hanskimvz/NS6202HD/11.png

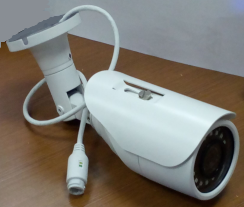
11.png
