hanskimvz/NS6202HD/schematic/NS6202_V4.1.PcbDoc.htm

Reporting Options

# File in Previous Format

Date | : | 2024-02-29
Time | : | 오후 3:50:26
Filename | : | D:\BACKUP\Hardwares\NS6202HD\schematic\NS6202_V4.1.PcbDoc

Version | Warning

This file was generated by an earlier version of the software
