hanskimvz/NS6202HD/schematic/NS6202_V4.0_b.PcbDoc.htm

Reporting Options

# File in Newer Format

Date | : | 2023-11-30
Time | : | 오후 5:58:30
Filename | : | D:\H_BAIDU\PROJECT\NS6202_IPN\schematic\NS6202_V4.0_b.PcbDoc

Version | Warning
Release 15 | CAUTION - Support of separate solder masks for top & bottom of pads added.
Release 15.1 | CAUTION - Support Multi-line PCB Text added.
Release 16.0 | CAUTION - Pad/Via hole size tolerance value added.
Release 17.0 | CAUTION - Component parameters added.
Release 17.0 | CAUTION - Support of backdrilling
Release 17.1 | CAUTION - Support of waived violations
Release 17.1 | CAUTION - Support of object specific keepouts

This file was generated by a later version of the software
