hanskimvz/NS6202HD/SMART IR Board PIC.jpg

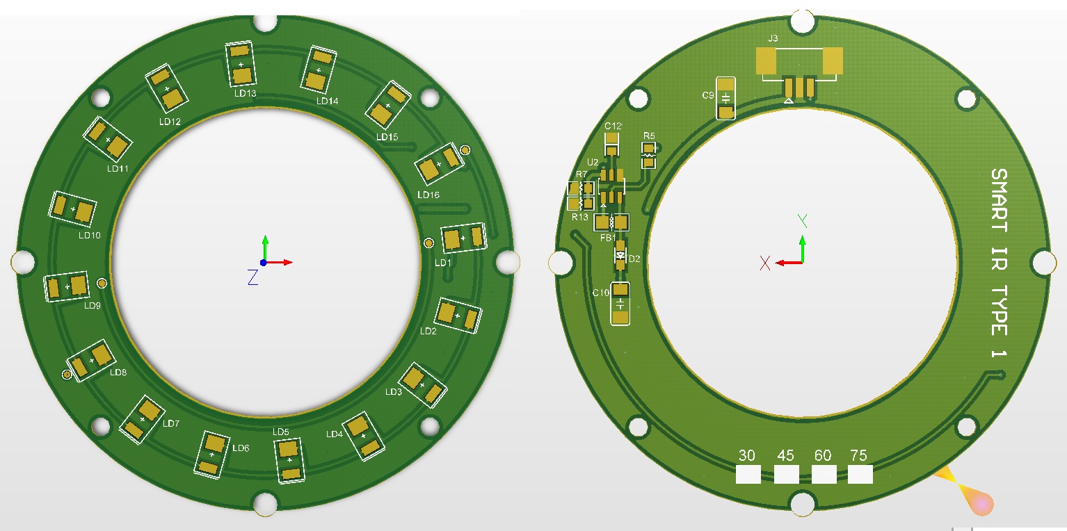
SMART IR Board PIC.jpg
