hanskimvz/NS6202HD/NS6202HD_Product_MC.xlsx

 |  |  | USD | CNY | Quantity | USD | CNY
1 | NVN042M |  | 34 |  | 1 | 34 | 0 |  | SEJIN
2 | Manu. Royalty |  | 5 |  | 1 | 5 | 0 |  | UDP
3 | IMA1102 |  | 22 |  | 1 | 22 | 0 |  | SEJIN
 | NS6202HD_Board |  | 10 |  | 1 | 10 | 0
5 | IR Board |  |  | 18 | 1 | 0 | 18
6 | Chassis |  |  | 37 | 1 | 0 | 37 |  | order made
 | Thermal Bracket |  |  | 14 | 1 | 0 | 14 |  | order made
8 | LAN/Power Cable |  |  | 9 | 1 | 0 | 9 |  | order made
9 | Lens | 6mm |  | 11 | 1 | 0 | 11 |  | https://item.taobao.com/item.htm?spm=a1z10.5-c.w4002-7821947878.21.Xr6X1F&id=41694765811
10 | IR-cut | M12 Ir-cut |  | 3.5 | 1 | 0 | 3.5 |  | https://item.taobao.com/item.htm?spm=a1z0d.7625083.1998302264.5.voLotO&id=41616812732
11 | Bolt | m2_3mm, IRCUT |  | 0.1 | 2 | 0 | 0.2
12 | Bolt | m1.5_3mm/Lens |  | 0.1 | 1 | 0 | 0.1
13 | PSU | 12V DC 1A |  | 15 | 0 | 0 | 0 |  | https://item.taobao.com/item.htm?spm=a230r.1.14.16.X3Y5ct&id=16992516911&ns=1&abbucket=13#detail
14 | support | m2_0+2+0 |  | 0.1 | 4 | 0 | 0.4
 |  | m2_0+18+3 |  | 0.24 | 4 | 0 | 0.96 |  | https://item.taobao.com/item.htm?spm=a1z0d.6639537.1997196601.112.pfU5WP&id=26042080370
 |  | m2_0+13+3 |  | 0.24 | 4 | 0 | 0.96
 |  | m2_0+4+0 |  | 0.16 | 4 | 0 | 0.64
18 | bolt | m2_5mm |  | 0.1 | 4 | 0 | 0.4
19 | Cable | IR-b'rd to ext |  | 0.2 | 1 | 0 | 0.2
 |  |  |  | 0.1 |  | 0 | 0
21 | Packing |  |  | 5 | 1 | 0 | 5
 | Lic(surv) |  | 37 |  | 0.2 | 7.4 | 0
 | Delivery(K-C) |  |  | 4 | 0 | 0 | 0
 |  |  |  |  |  | 78.4 | 101.36
 |  |  |  | Exchange Rate | 7 | 548.8 | 101.36 | 650.16 |  | 1600 | 949.84
 |  |  |  |  |  |  |  | 715.176
