hanskimvz/NS6202HD/NS6202HD_Product_PL.xlsx

Sheet: PL
No. | Part/Item | Descrition | Q'ty | Source
1 | NVN042M | VCA and Compression module | 1 | SEJIN | SEJIN
2 | IMA1102 | Image Sensor board | 1 | SEJIN | SEJIN
3 | SC6202HD_Ext | Extention board | 1 | SEJIN
4 | NS6202IR | IR Board | 1 | SEJIN
5 | Chassis B75A | Case for Bullet Camera | 1 | ECCLE
6 | Thermal Bracket |  | 1 | ECCLE
7 | LAN/Power Cable |  | 1 | XIngFeng
8 | Lens | 4mm focal lenght | 1 | ChuangYueVision
9 | IR-cut | M12 Ir-cut | 1 | ChuangYueVision
10 | Bolt | m2_3mm, IRCUT | 1
11 | Bolt | m1.5_3mm/Lens | 1
12 | PSU | 12V DC 1A | 1
13 | support | m2_0+2+0 | 1
14 | support | m2_0+18+3 | 1
15 | support | m2_0+13+3 | 1
16 | support | m2_0+4+0 | 1
17 | bolt | m2_5mm | 1
18 | Cable | IR-b'rd to ext | 1

Sheet: SC6202IR
 |  |  | 30degree IR Board |  | 60degree IR Board
Item | Quantity | Reference | Part | Footprint | Part | Footprint
1 | 2 | C9,C10 | 4.7uF-25V-3216 | C3216 | 4.7uF-25V-3216 | C3216
2 | 1 | C12 | 220nF | CS-1608 | 220nF | CS-1608
3 | 1 | D2 | DFLS140 | DS-KDS160 | DFLS140 | DS-KDS160
4 | 1 | FB1 | 60 | LS-2012 | 60 | LS-2012
5 | 1 | J3 | 12505WS-03 | 12505WS-3P | 12505WS-03 | 12505WS-3P
6 | 16 | LD1,LD2,LD3,LD4,LD5,LD6,LD7,LD8,LD9,LD10,LD11,LD12,LD13,LD14,LD15,LD16 | LTJI0108W30 | SMD_IR_LED | LTJI0106W30 | SMD_IR_LED
7 | 1 | R5 | 33 | RS-1608 | 33 | RS-1608
8 | 2 | R7,R13 | 2_F | RS-1608 | 4.99F | RS-1608
10 | 1 | U2 | TPS61165DBVR | SOT23-6 | TPS61165DBVR | SOT23-6

Sheet: SC6202HD_EXT
 | Comment | Designator | Footprint | LibRef | Quantity | MQT
1 | 0.1uF | BC1, BC3, BC4, BC5, BC6, BC7, BC9, C12, C13, C23, C28 | CS-1005 | 0.1uF | 11 | 11
2 | 0.1uF | BC2, C1, C24, C25 | CS-1608 | 0.1uF | 4 | 4
3 | 10uF | BC10, C8 | CTS-3216 | 10uF | 2 | 0
4 | 220pF | C2 | CS-1005 | 220pF | 1 | 1
5 | 1nF | C3 | CS-1005 | 1nF | 1 | 1
6 | 2.2nF | C4, C5 | CS-1005 | 2.2nF | 2 | 2
7 | 10nF | C6, C7, C15, C20, C21 | CS-1005 | 10nF | 5 | 5
8 | 47pF | C9 | CS-1005 | 47pF | 1 | 1
9 | 22uF | C10 | CTS-3216 | 22uF | 1 | 0
10 | 4.7uF-25V | C11 | C3216 | 4.7uF-25V | 1 | 1
11 | 3.3nF | C14 | CS-1005 | 3.3nF | 1 | 1
12 | 22uF-2012-6.3V | C16, C17 | CS-2012 | 22uF-2012-6.3V | 2 | 2
13 | 2.2uF | C22, C27 | CS-1608 | 2.2uF | 2 | 0
14 | 22uF | C26 | CS-2012 | 22uF | 1 | 0
15 | RB051L-40 | D1 | SOD-106 | RB051L-40 | 1 | 1
16 | 1N4148 | D2 | SOD-523 | 1N4148 | 1 | 1
17 | 60 | FB2, FB3, FB4 | LS-1608 | 60 | 3 | 3
18 | AXK6F50547 | J1,J2 | AXK6F50547 | AXK6F50547 | 2 | 2
19 | 12505WS-08 | J3 | 12505WS-8P | 12505WS-08 | 1 | 1
20 | 12505WS-08 | J12 | 12505WS-8P | 12505WS-08 | 1 | 0
21 | 05005HS-40 | J4 | 05005HS-40P | 05005HS-40 | 1 | 1
22 | 12505WS-06 | J5 | 12505WS-6P | 12505WS-06 | 1 | 1
23 | 12505WS-06 | J9 | 12505WS-6P | 12505WS-06 | 1 | 1
24 | 05005HS-40 | J6 | 05005HS-10P | 05005HS-40 | 1 | 1
25 | 12505WS-04 | J11 | 12505WS-4P | 12505WS-04 | 1 | 0
26 | 12505WS-03 | J13 | 12505WS-3P | 12505WS-03 | 1 | 0
27 | CDRH5D18NP-100NC-10uH | L1 | CDRH5D18NP | CDRH5D18NP-100NC-10uH | 1 | 1
28 | 4.04pi | MH1, MH2, MH3, MH4 | VA-2.2 | 4.04pi | 4 | 0
29 | PC817 | PC1 | PC817 | PC817 | 1 | 1
30 | ASSR-4118 | PC2 | ASSR-4118 | ASSR-4118 | 1 | 1
31 | MMBT6427 | Q1, Q2, Q4 | SOT-23 | MMBT6427 | 3 | 3
32 | MMBT3906 | Q3 | SOT-23 | MMBT3906 | 1 | 1
33 | 10K | R3, R4, R7, R8, R9, R11, R16, R17, R22, R24, R25, R28, R56 | RS-1005 | 10K | 13 | 13
34 | 1K | R5, R6, R10, R15, R34, R36, R49, R50, R57 | RS-1005 | 1K | 9 | 9
35 | 330 | R12, R14 | RS-1005 | 330 | 2 | 2
36 | 2.2K | R13, R44, R47, R54 | RS-1005 | 2.2K | 4 | 4
37 | 47 | R23, R29 | RS-1005 | 47 | 2 | 2
38 | 120/NI | R26 | RS-1005 | 120/NI | 1 | 0
39 | 4.7K | R27, R35 | RS-1005 | 4.7K | 2 | 2
40 | 0 | R30, R39 | RS-1005 | 0 | 2 | 2
41 | 100 | R31, R38, R46, R48, R52 | RS-1005 | 100 | 5 | 5
42 | 75 | R32, R33 | RS-1005 | 75 | 2 | 2
43 | 9.1_F | R37, R40, R45, R51 | RS-1005 | 9.1_F | 4 | 4
44 | 100K | R41 | RS-1005 | 100K | 1 | 1
45 | 26.1K_1% | R42 | RS-1005 | 26.1K_1% | 1 | 1
46 | 10K_1% | R43 | RS-1005 | 10K_1% | 1 | 1
47 | 2.2K//NI | R53 | RS-1005 | 2.2K//NI | 1 | 0
48 | 10 | R55 | RS-1005 | 10 | 1 | 1
49 | 0/NI | R58 | RS-1005 | 0/NI | 1 | 0
50 | TRC41604NL | T1 | TRC41604NL | TRC41604NL | 1 | 1
51 | TP | TP1, TP2 | TP | TP | 2 | 0
52 | MAX3485ESA | U3 | SOIC-8 | MAX3485ESA | 1 | 1
53 | DRV8834PWP | U4, U6 | TSSOP-24-PAD | DRV8834PWP | 2 | 0
54 | MP1482 | U5 | SOIC-8 | MP1482 | 1 | 1
55 | LM386M-1 | U9 | SOIC-8 | LM386M-1 | 1 | 0
