hanskimvz/NS6202HD/NS6202HD V3.0 Board BOM.xlsx

TITLE Revised: Monday, November 06, 2017
NS6202HD Revision:3.0
Item | Quantity | Reference | Part | Footprint
1 | 4 | BC1,BC4,C35,C36 | 0.1uF | CS-1005
2 | 4 | C1,BC2,C24,C25 | 0.1uF | CS-1608
3 | 1 | BC38 | 22uF | CS-2012
4 | 1 | C2 | 1nF/NI | CS-1005
5 | 2 | C6,C7 | 2.2nF | CS-1005
6 | 1 | C31 | 10nF | CS-1005
7 | 3 | C32,C33,C38 | 22uF-2012-6.3V | CS-2012
8 | 1 | C34 | 4.7uF-25V | C3216
9 | 1 | C37 | 3.3nF | CS-1005
10 | 1 | D1 | 1N4001 | SOD-106
11 | 1 | D2 | 1N4148 | SOD-523
12 | 2 | FB5,FB7 | 60 | LS-1608
13 | 1 | FB6 | 60/NI | LS-1608 | NI
14 | 1 | J1 | AXK6F30547 | AXK6F50547
15 | 1 | J2 | AXK6F50347 | AXK6F50547
16 | 1 | J3 | 12505WS-08 | 12505WS-8P
17 | 1 | J4 | 05005HS-40 | 05005HS-40P
18 | 1 | J5 | 12505WS-06 | 12505WS-6P
19 | 1 | J6 | CON_u-SD/NI | CON_u-SD
20 | 1 | J7 | 12505WS-2P | 12505WS-2P
21 | 3 | J8,J9,J11 | 12505WS-4P | 12505WS-4P
22 | 1 | J12 | 12512WS-02 | 12512WS-2P
23 | 1 | L1 | CDRH5D18NP-100NC-10uH | CDRH5D18NP
24 | 4 | MH1,MH2,MH3,MH4 | 4.04pi | VA-2.2 | NI
25 | 1 | PC1 | PC817 | PC817
26 | 1 | PC2 | ASSR-4118
27 | 3 | Q1,Q2,Q4 | MMBT6427 | SOT-23
28 | 1 | Q3 | MMBT3906 | SOT-23
29 | 2 | RP6,RP7 | 10K | RP-4_1005
30 | 10 | R3,R4,R9,R11,R16,R17,R22, | 10K | RS-1005
 |  | R24,R25,R28
31 | 5 | R5,R6,R7,R10,R15 | 1K | RS-1005
32 | 1 | R8 | 0/NI | RS-1005
33 | 2 | R12,R14 | 330 | RS-1005
34 | 2 | R13,R44 | 2.2K | RS-1005
35 | 2 | R23,R29 | 47 | RS-1005
36 | 1 | R26 | 120/NI | RS-1005
37 | 1 | R31 | 100 | RS-1005
38 | 2 | R32,R33 | 75 | RS-1005
39 | 1 | R41 | 100K | RS-1005
40 | 1 | R42 | 26.1K_1% | RS-1005
41 | 1 | R43 | 10K_1% | RS-1005
42 | 1 | SW1 | SW PB | SWS-CTT-1131U
43 | 1 | T1 | TRC41604NL | TRC41604NL
44 | 1 | U3 | MAX3485ESA | SOIC-8
45 | 1 | U5 | MP1482 | SOIC-8
46 | 1 | U6 | 78L05 | SOT-89
