hanskimvz/NS6202HD/Chassis/NS6202_Cam_module.SLDASM

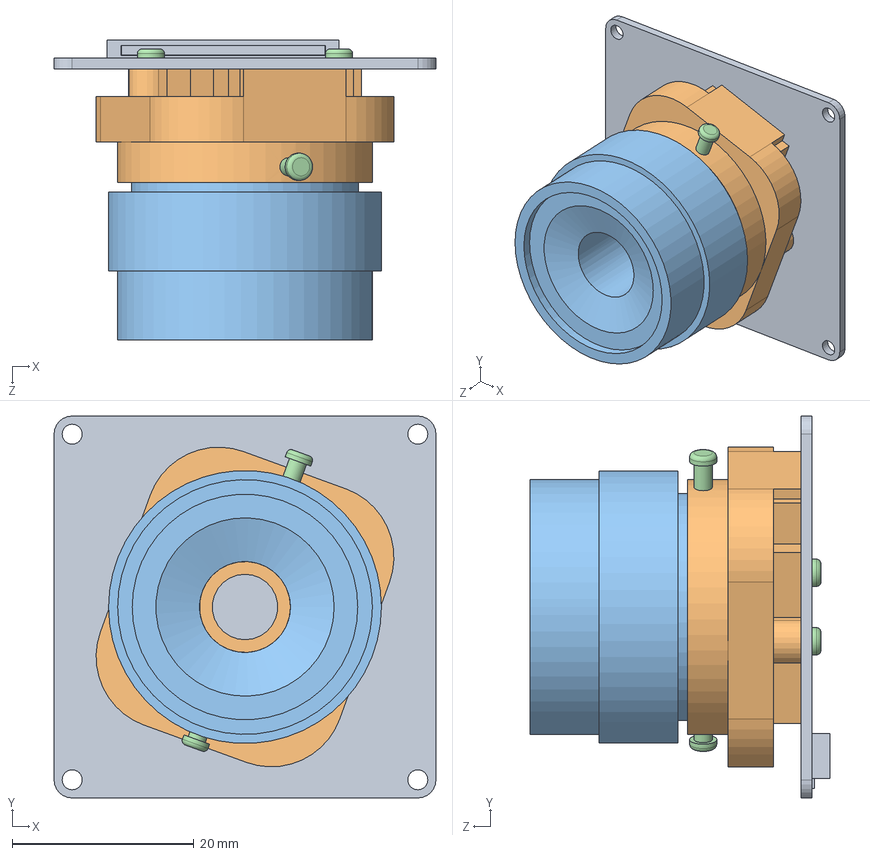
[picture p4: CAD file, 2024-02-29]
Chassis/NS6202_Cam_module.SLDASM
42.0 x 42.0 x 33.0 mm
IMA1102
IR_CUT_22mm_CS
3402Lens
bolt_m2_4mm x 4
