hanskimvz/NS6202HD/Chassis/NS6202.SLDASM

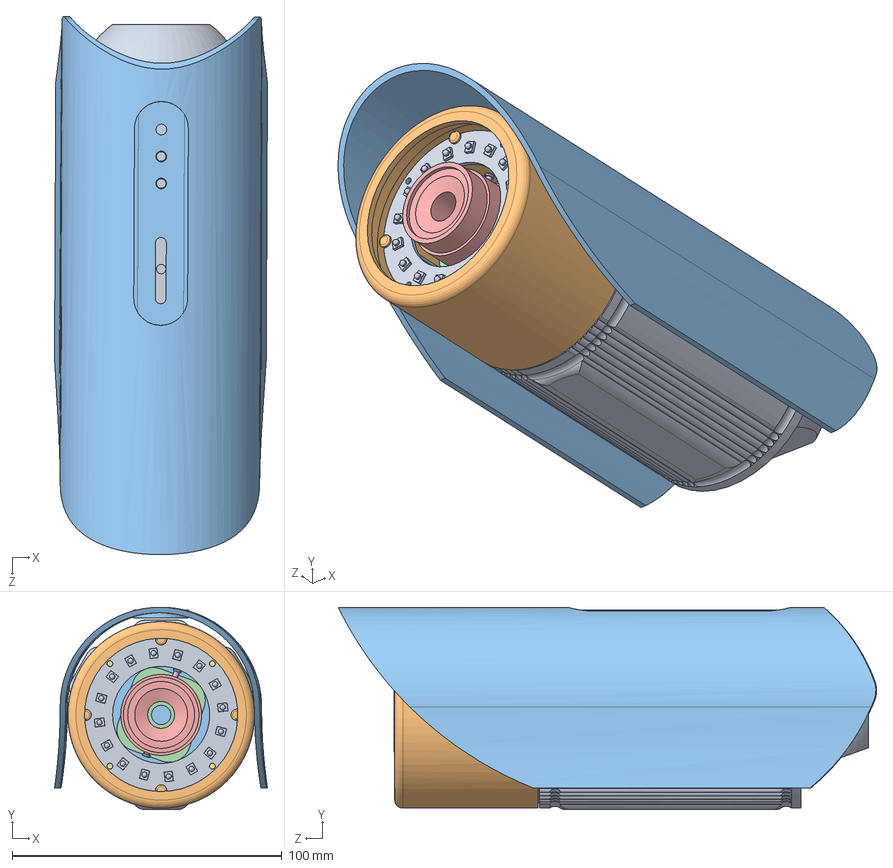
[picture p5: CAD file, 2024-02-29]
Chassis/NS6202.SLDASM
79.0 x 75.0 x 199.6 mm
NS6202_partition
Ext_board
NVN042M
support_m2_13mm x 4
bolt_m2_16mm x 4
support_m2_0_4_0mm x 4
support_m2_0_2_0mm x 4
IMA1102
IR_CUT_22mm_CS
3402Lens
bolt_m2_4mm x 4
bolt_m2_5mm x 4
support_m2.5_33mm,10-0 x 4
IR_Bord
bolt_m2.5_5mm x 4
