hanskimvz/NS6202HD/Chassis/NS6202_cam_body.SLDASM

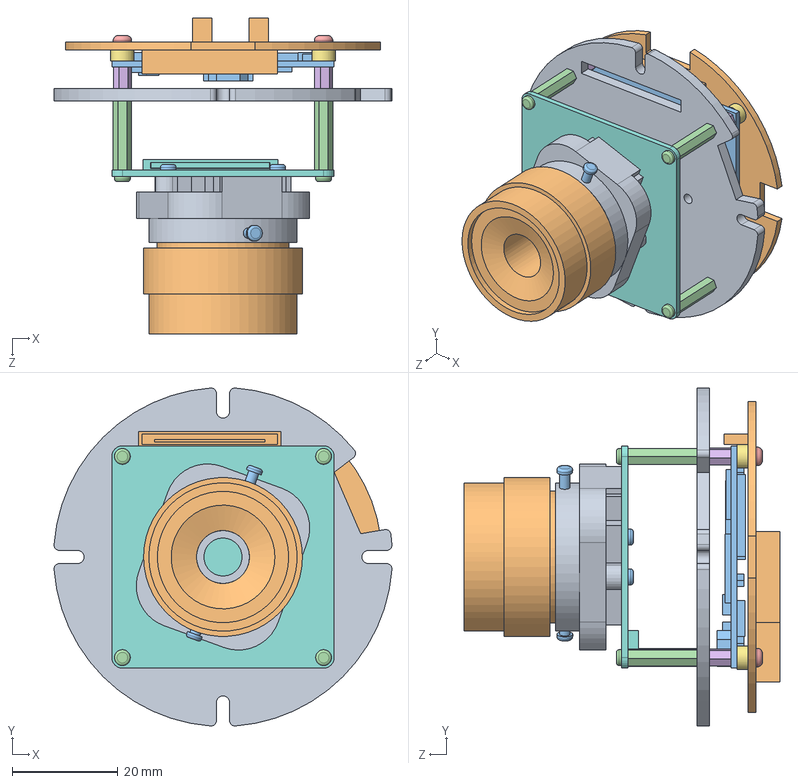
[picture p6: CAD file, 2024-02-29]
Chassis/NS6202_cam_body.SLDASM
63.8 x 63.8 x 59.7 mm
NS6202_partition
Ext_board
NVN042M
support_m2_13mm x 4
bolt_m2_16mm x 4
support_m2_0_4_0mm x 4
support_m2_0_2_0mm x 4
IMA1102
IR_CUT_22mm_CS
3402Lens
bolt_m2_4mm x 4
bolt_m2_5mm x 4
