hanskimvz/NS6202HD/Chassis/IR_CUT.SLDPRT

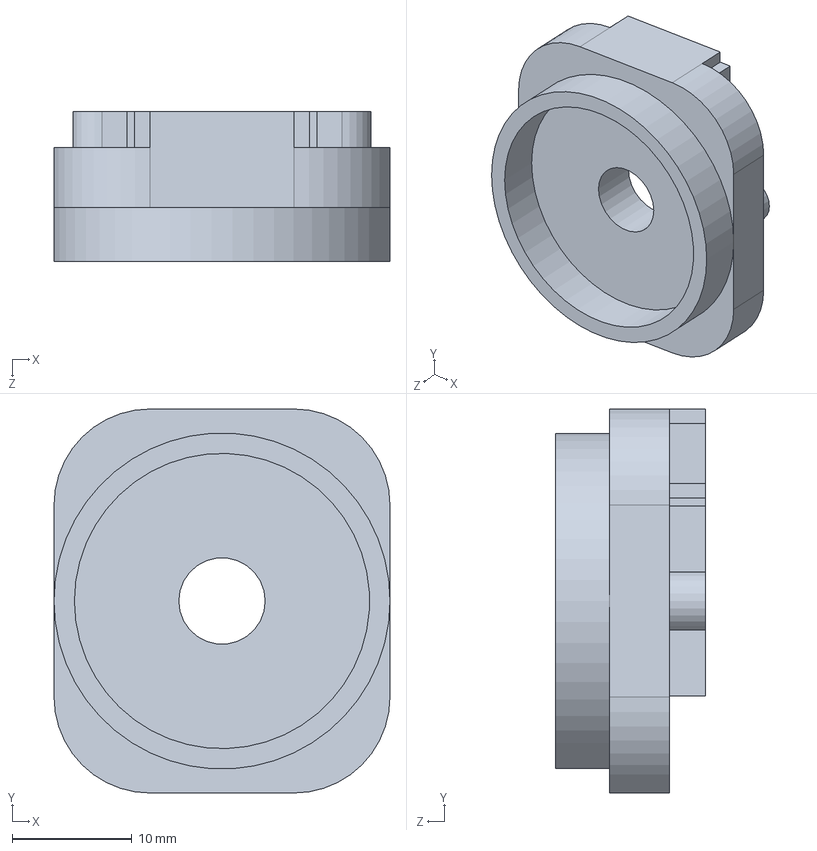
[picture p7: CAD file, 2024-02-29]
Chassis/IR_CUT.SLDPRT
28.0 x 32.0 x 12.5 mm
