hanskimvz/NS6202HD/Chassis/NS6202_90angle_support.SLDPRT

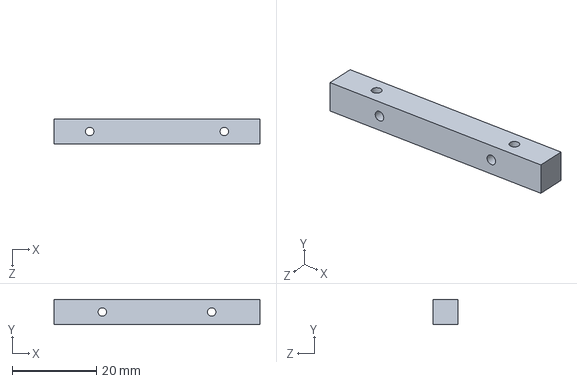
[picture p8: CAD file, 2024-02-29]
Chassis/NS6202_90angle_support.SLDPRT
49.0 x 6.00 x 6.00 mm
