hanskimvz/NS6202HD/Chassis/IR_CUT_22mm_CS.SLDPRT

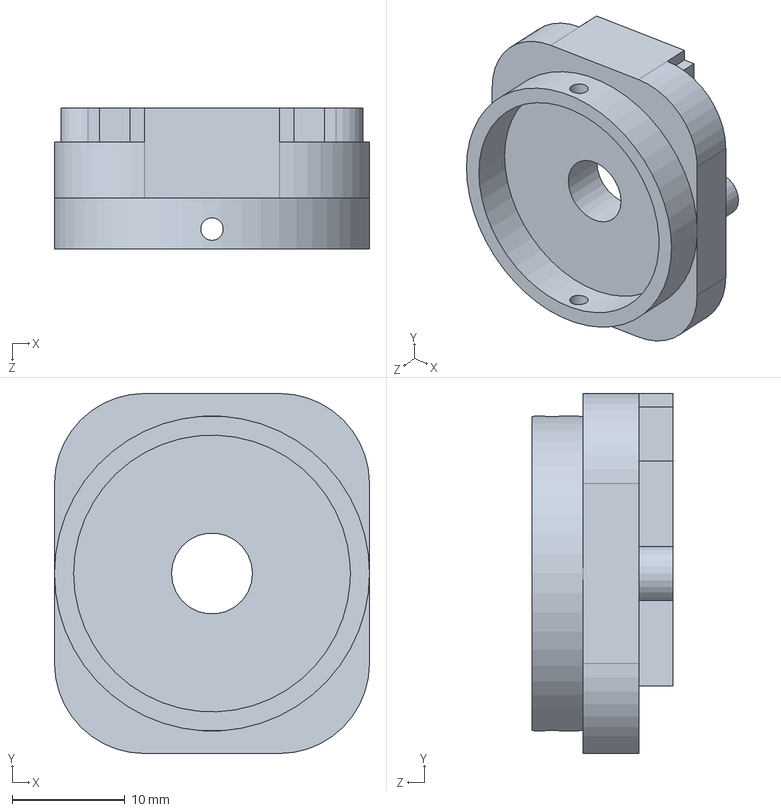
[picture p9: CAD file, 2024-02-29]
Chassis/IR_CUT_22mm_CS.SLDPRT
28.0 x 32.0 x 12.5 mm
