hanskimvz/NS6202HD/Chassis/Ext_board.SLDPRT

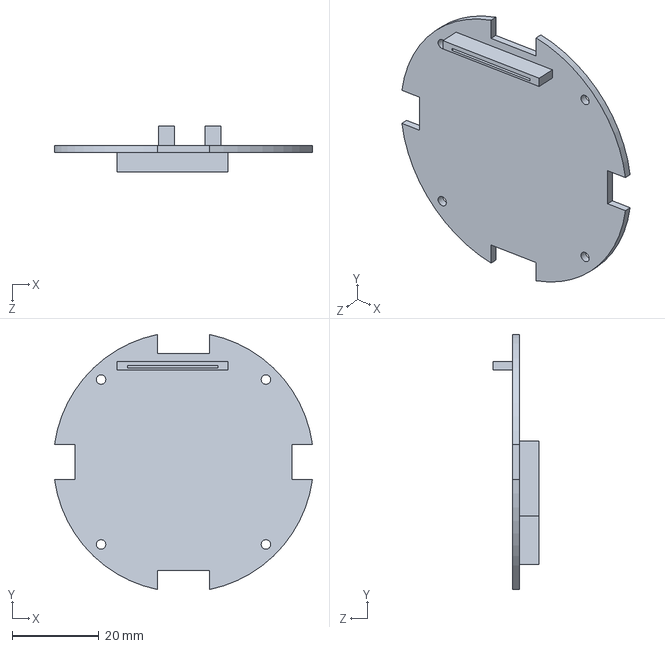
[picture p10: CAD file, 2024-02-29]
Chassis/Ext_board.SLDPRT
59.5 x 58.8 x 10.6 mm
