hanskimvz/NS6202HD/Chassis/support_m2_18mm.SLDPRT

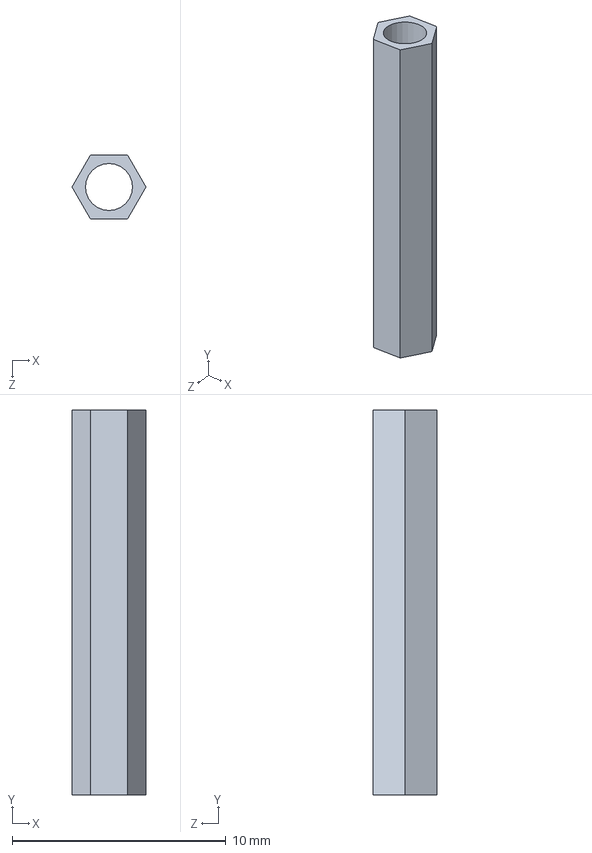
[picture p11: CAD file, 2024-02-29]
Chassis/support_m2_18mm.SLDPRT
3.46 x 18.0 x 3.00 mm
