hanskimvz/NS6202HD/Chassis/NS6202_partition_new.STEP

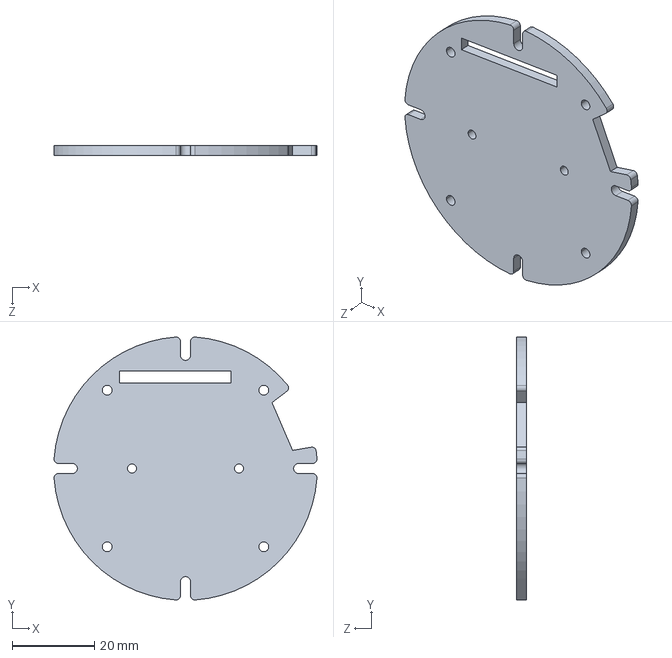
[picture p12: CAD file, 2024-02-29]
Chassis/NS6202_partition_new.STEP
63.8 x 63.8 x 2.40 mm
