hanskimvz/NS6202HD/Chassis/support_m2.5_33mm,10-0.SLDPRT

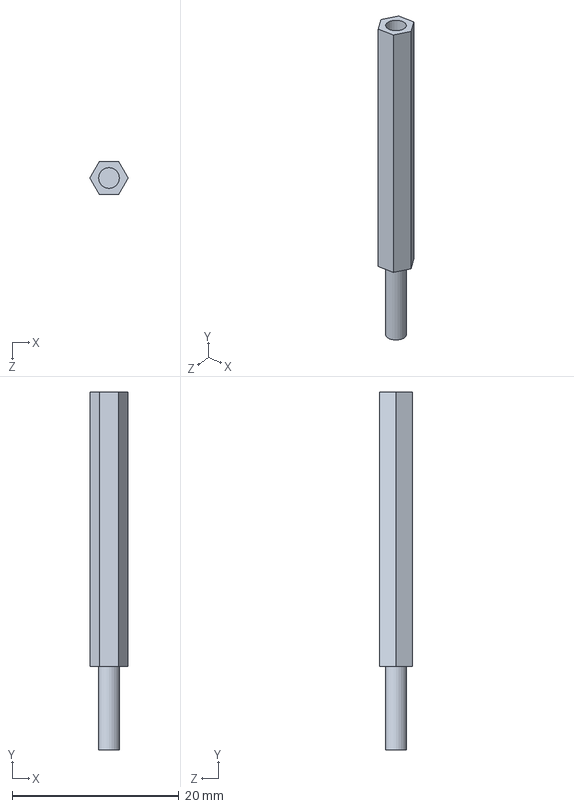
[picture p13: CAD file, 2024-02-29]
Chassis/support_m2.5_33mm,10-0.SLDPRT
4.62 x 43.0 x 4.00 mm
