hanskimvz/NS6202HD/Chassis/3402Lens.SLDPRT

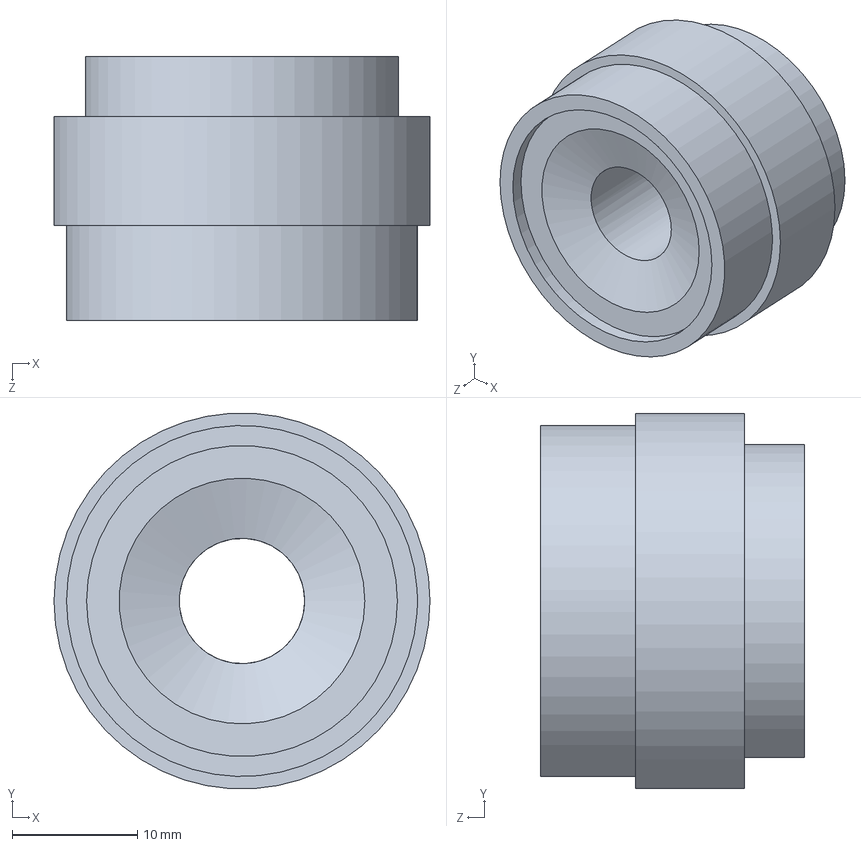
[picture p14: CAD file, 2024-02-29]
Chassis/3402Lens.SLDPRT
30.0 x 29.9 x 21.1 mm
