hanskimvz/NS6202HD/(list of files, cad)

Other CAD files:
Chassis/support_m2.5_33mm,10-0(H-PC--H--2019-09-07-20,49,33).SLDPRT
Chassis/NS6202_partition.STEP
Chassis/NS6202_partition.DXF
Chassis/NS6202_partition.IGS
Chassis/NS6202_partition.SLDPRT
Chassis/NS6202_partition_new.IGS
