hanskimvz/NS6202HD/ns6202_v2.0.pdf

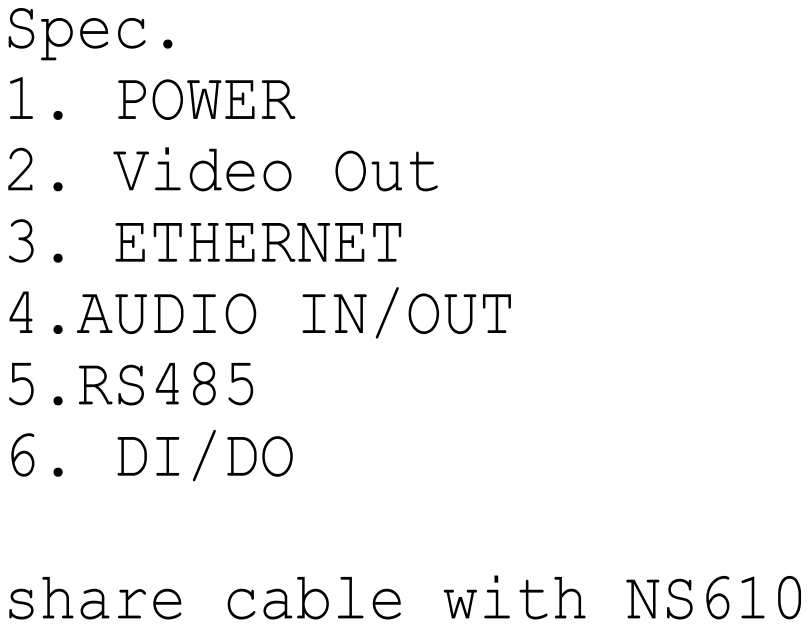
[picture p15: page 1]
Spec. 1. POWER 2. Video Out 3. ETHERNET 4.AUDIO IN/OUT 5.RS485 6. DI/DO; Title; Size; Document Number; Rev; Date:; Sheet; TITLE; Tuesday, November 15, 2016

share cable with NS610

### SUB/BOTTOM/FEMALE SUB/TOP/MALE

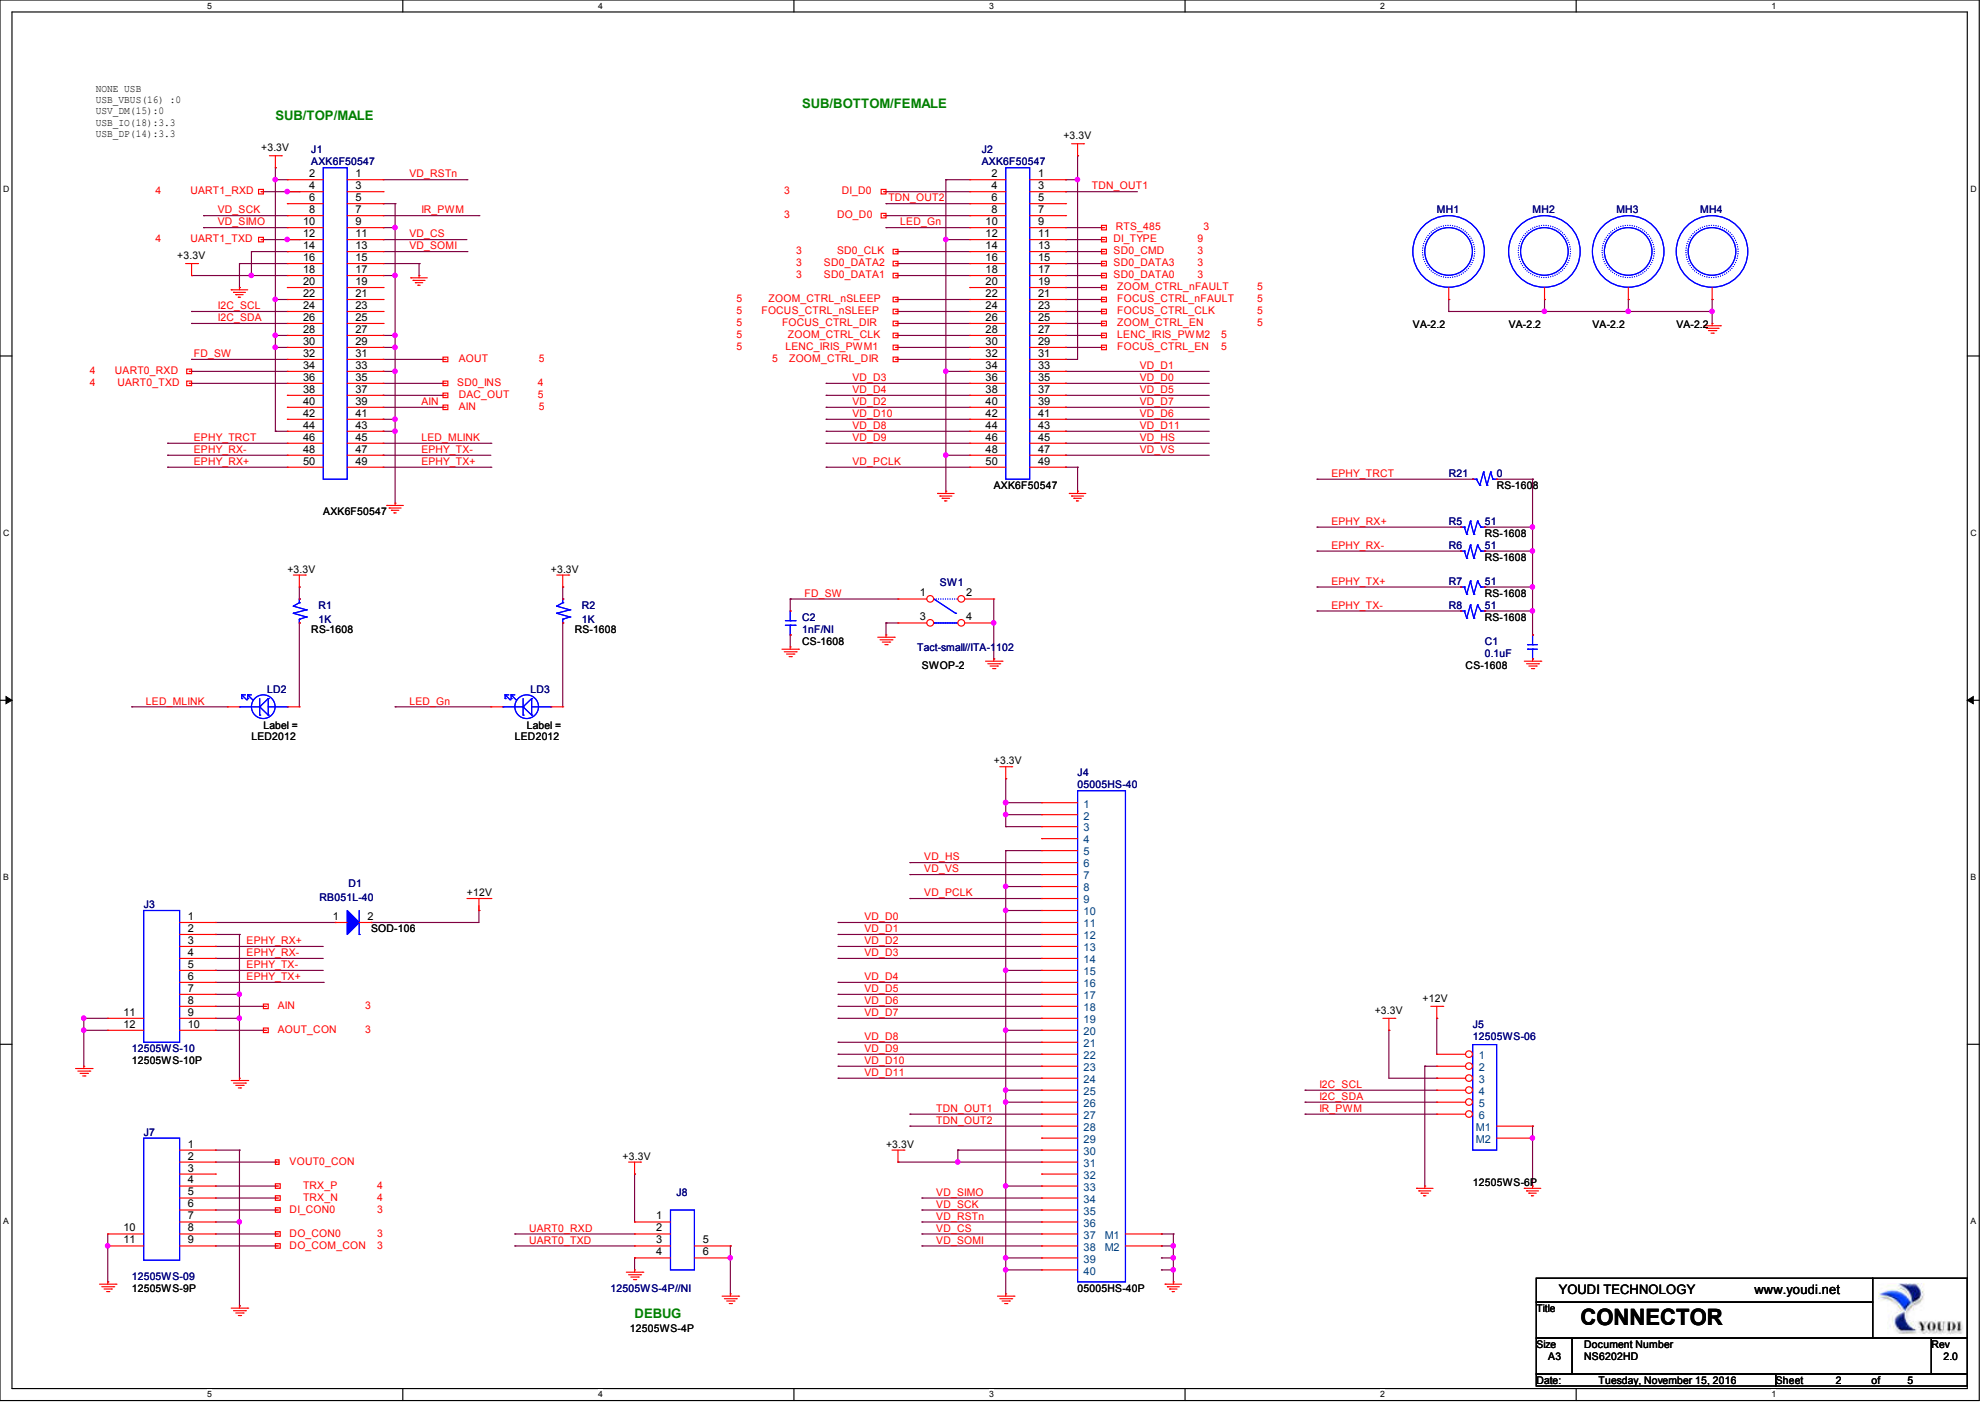
[picture p16: page 2]

D | D

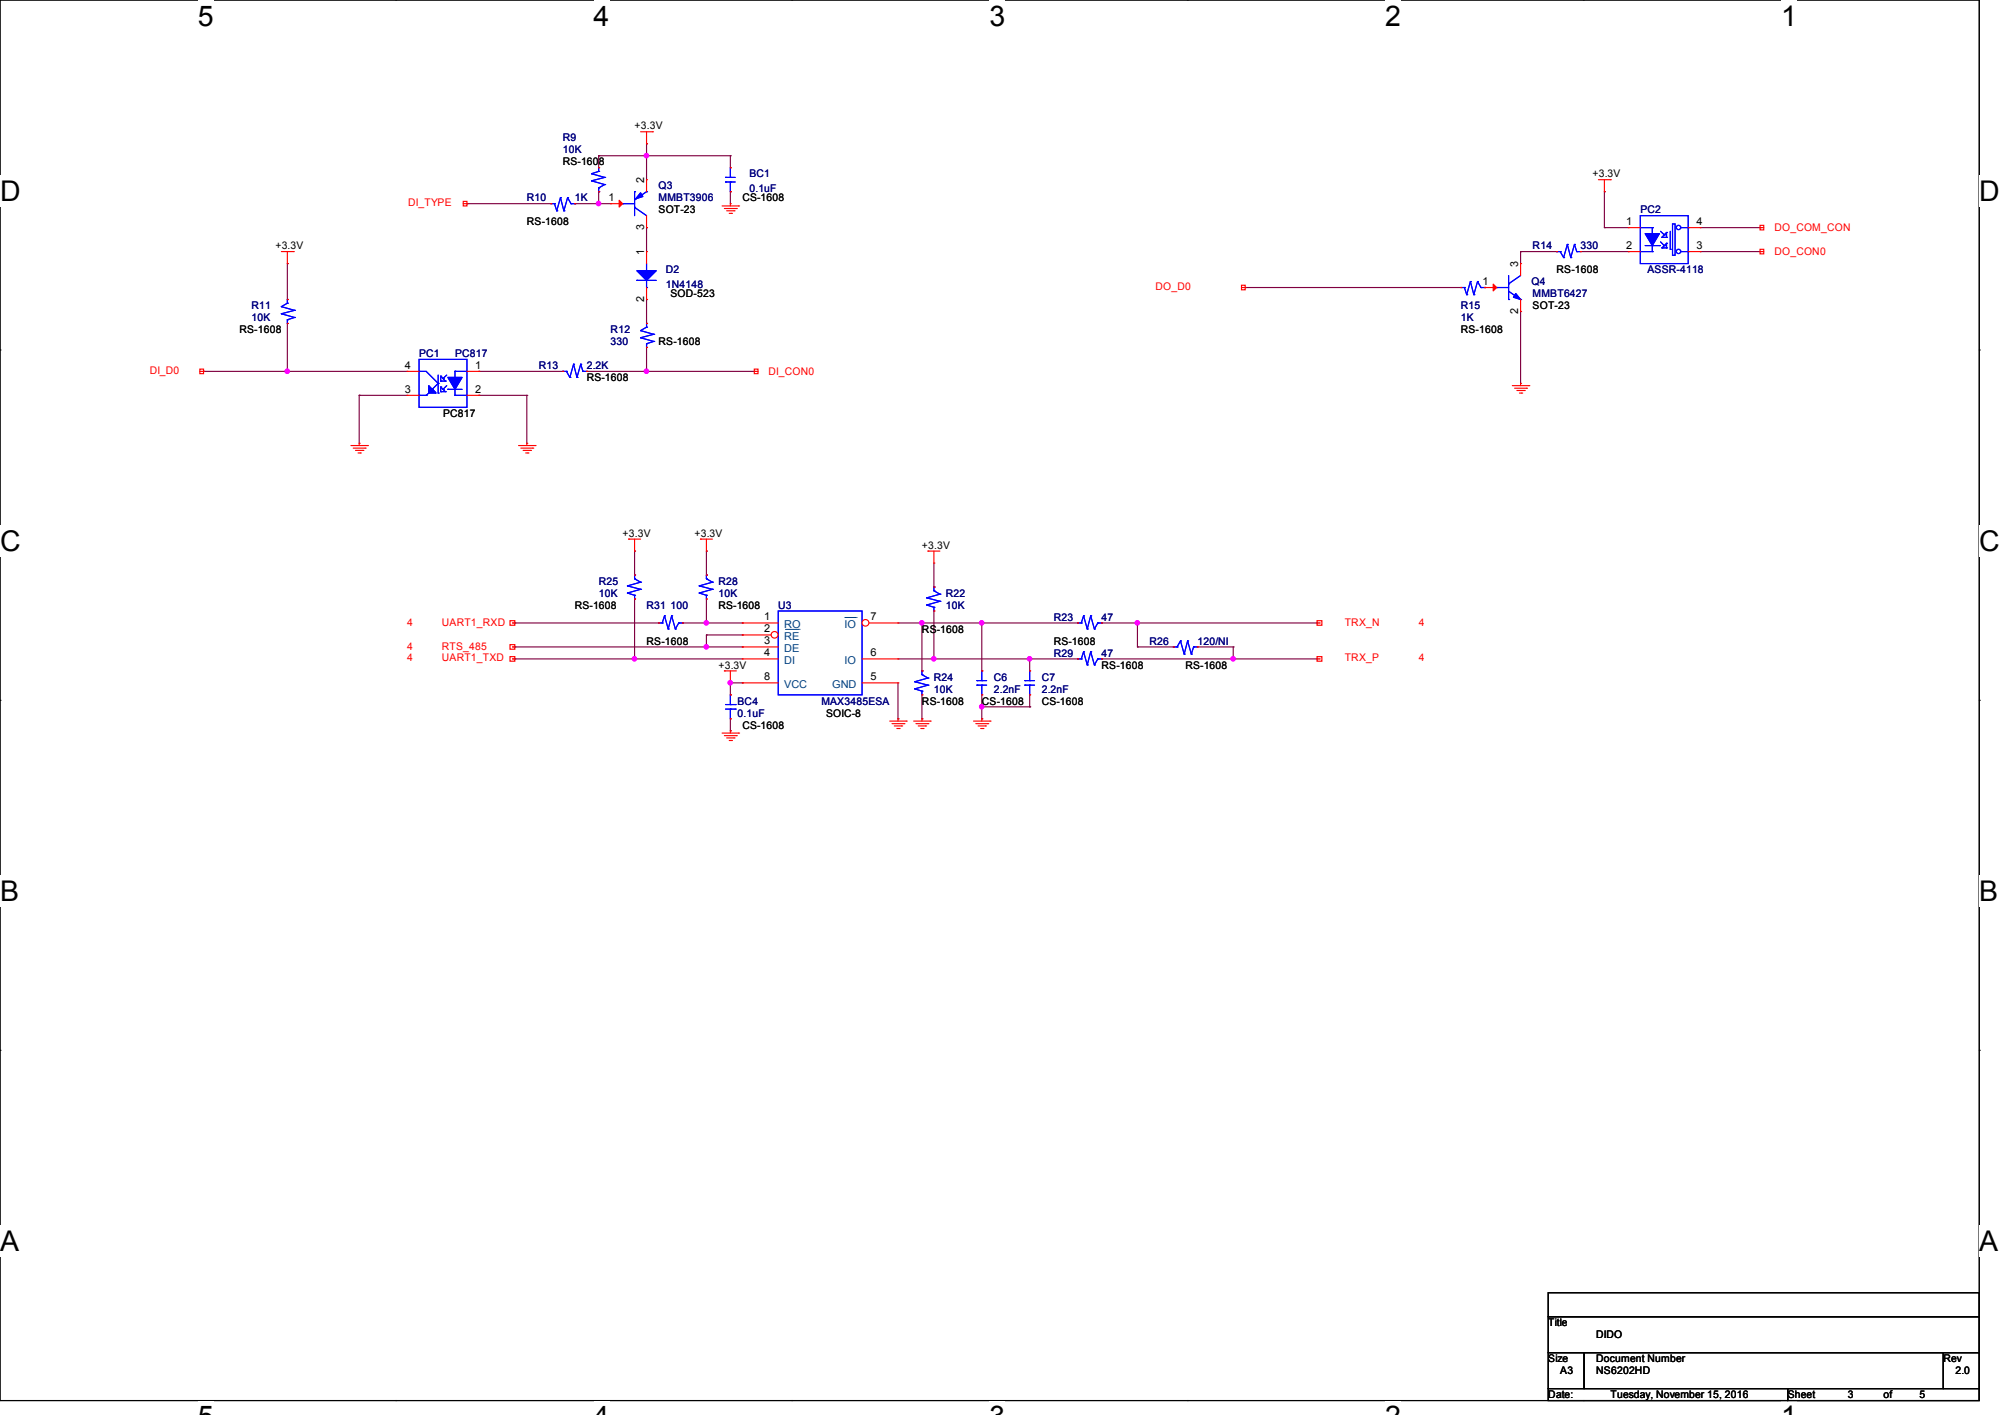
[picture p17: page 3]

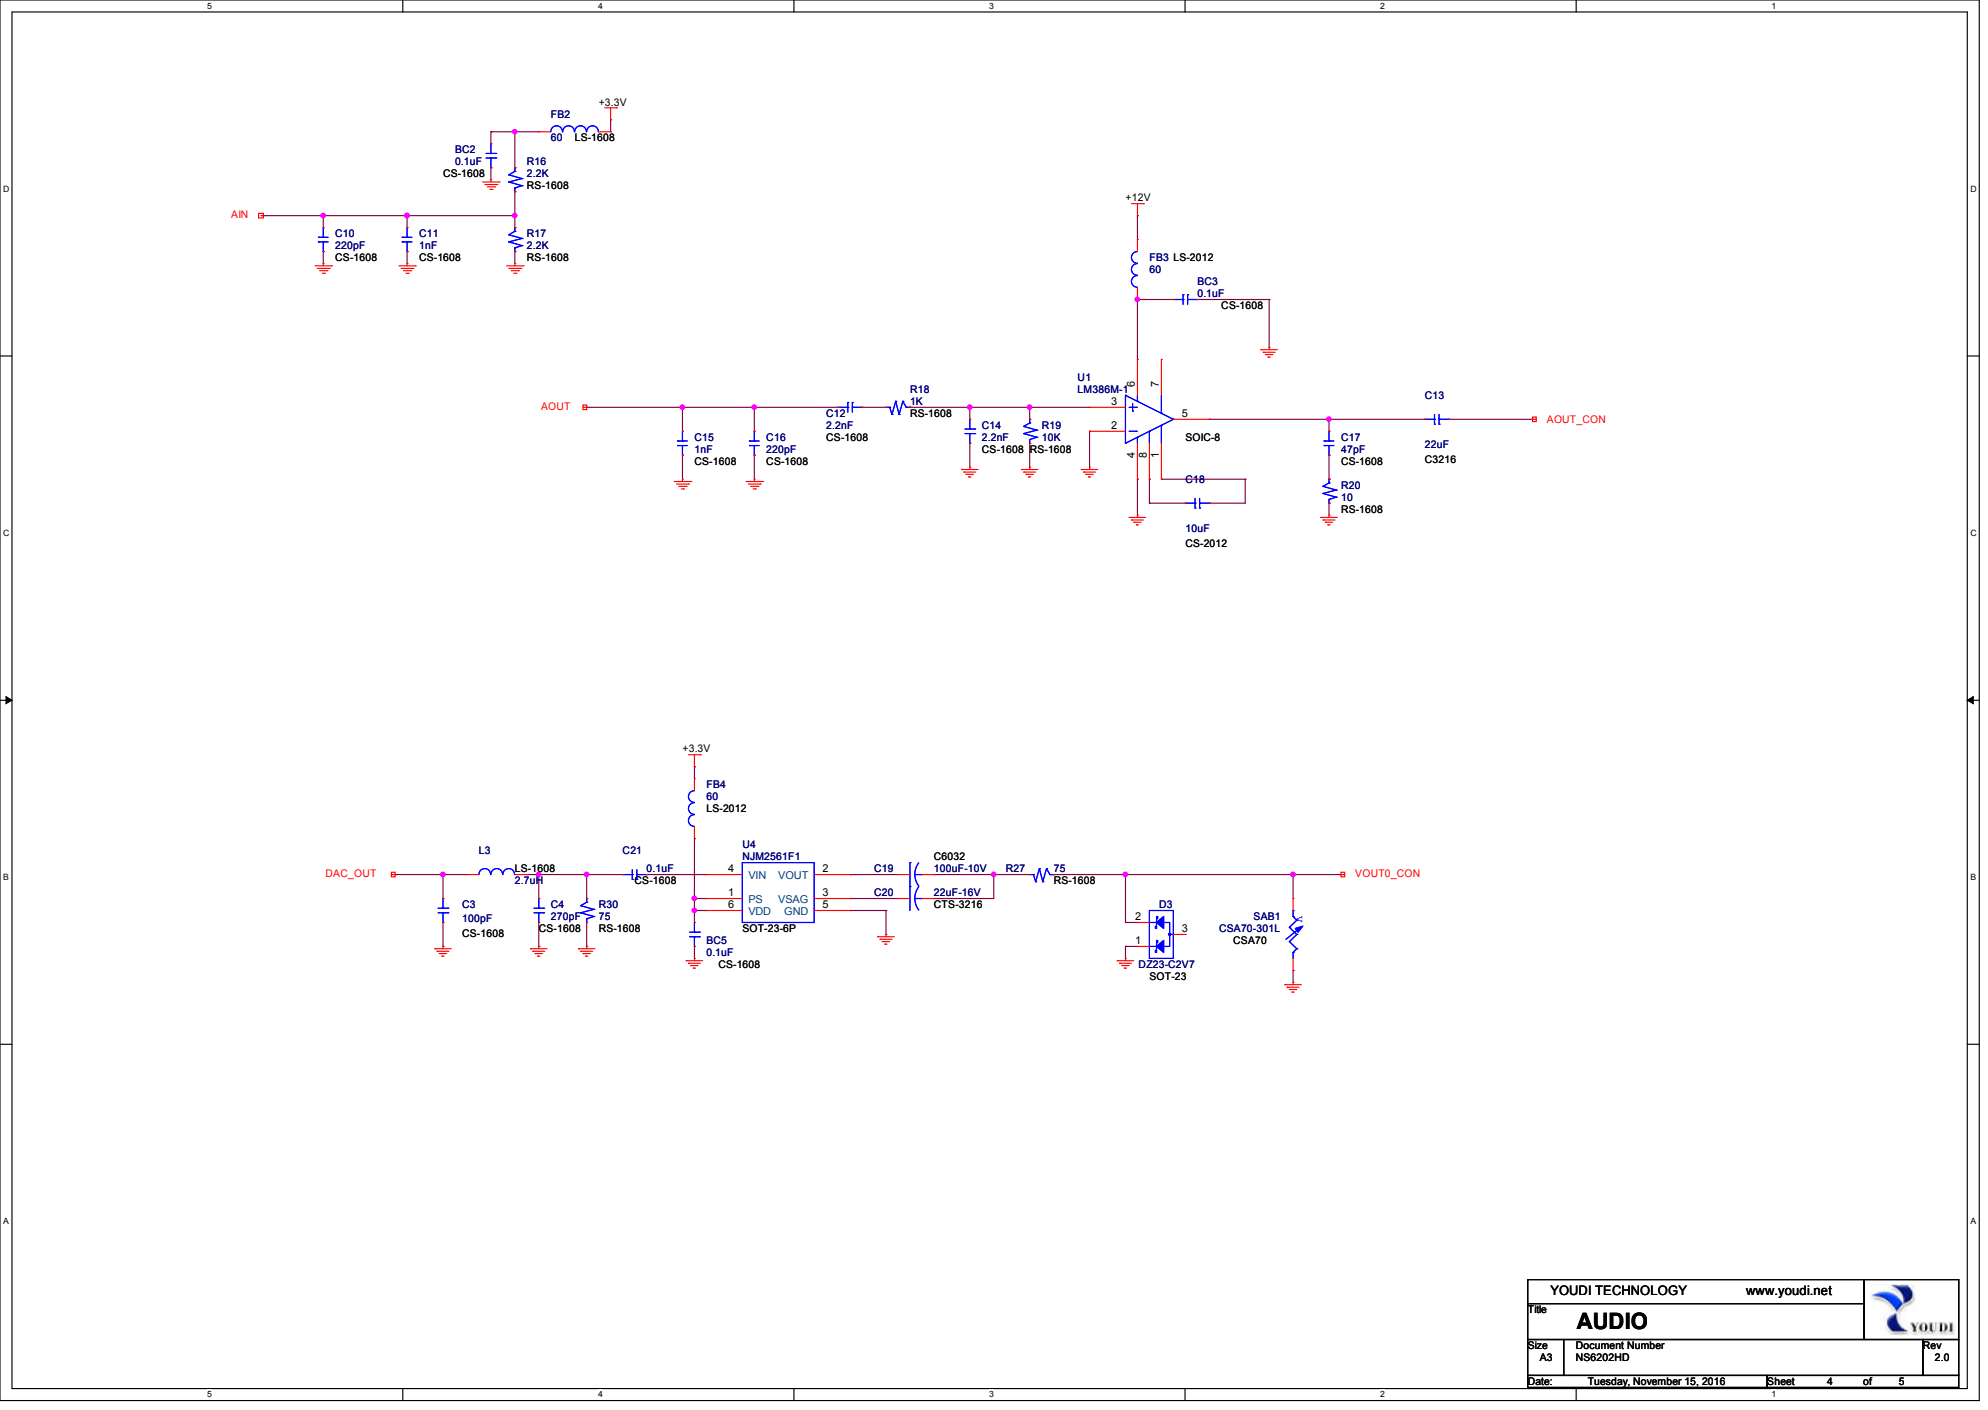
[picture p18: page 4]

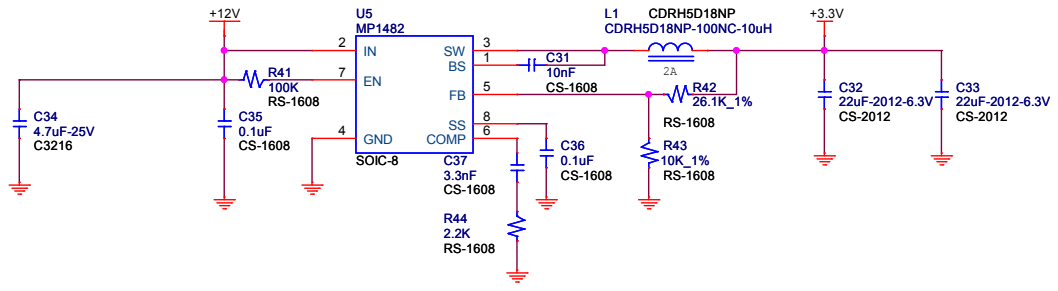
[picture p19: page 5]
