hanskimvz/NS6202HD/B75A.pdf

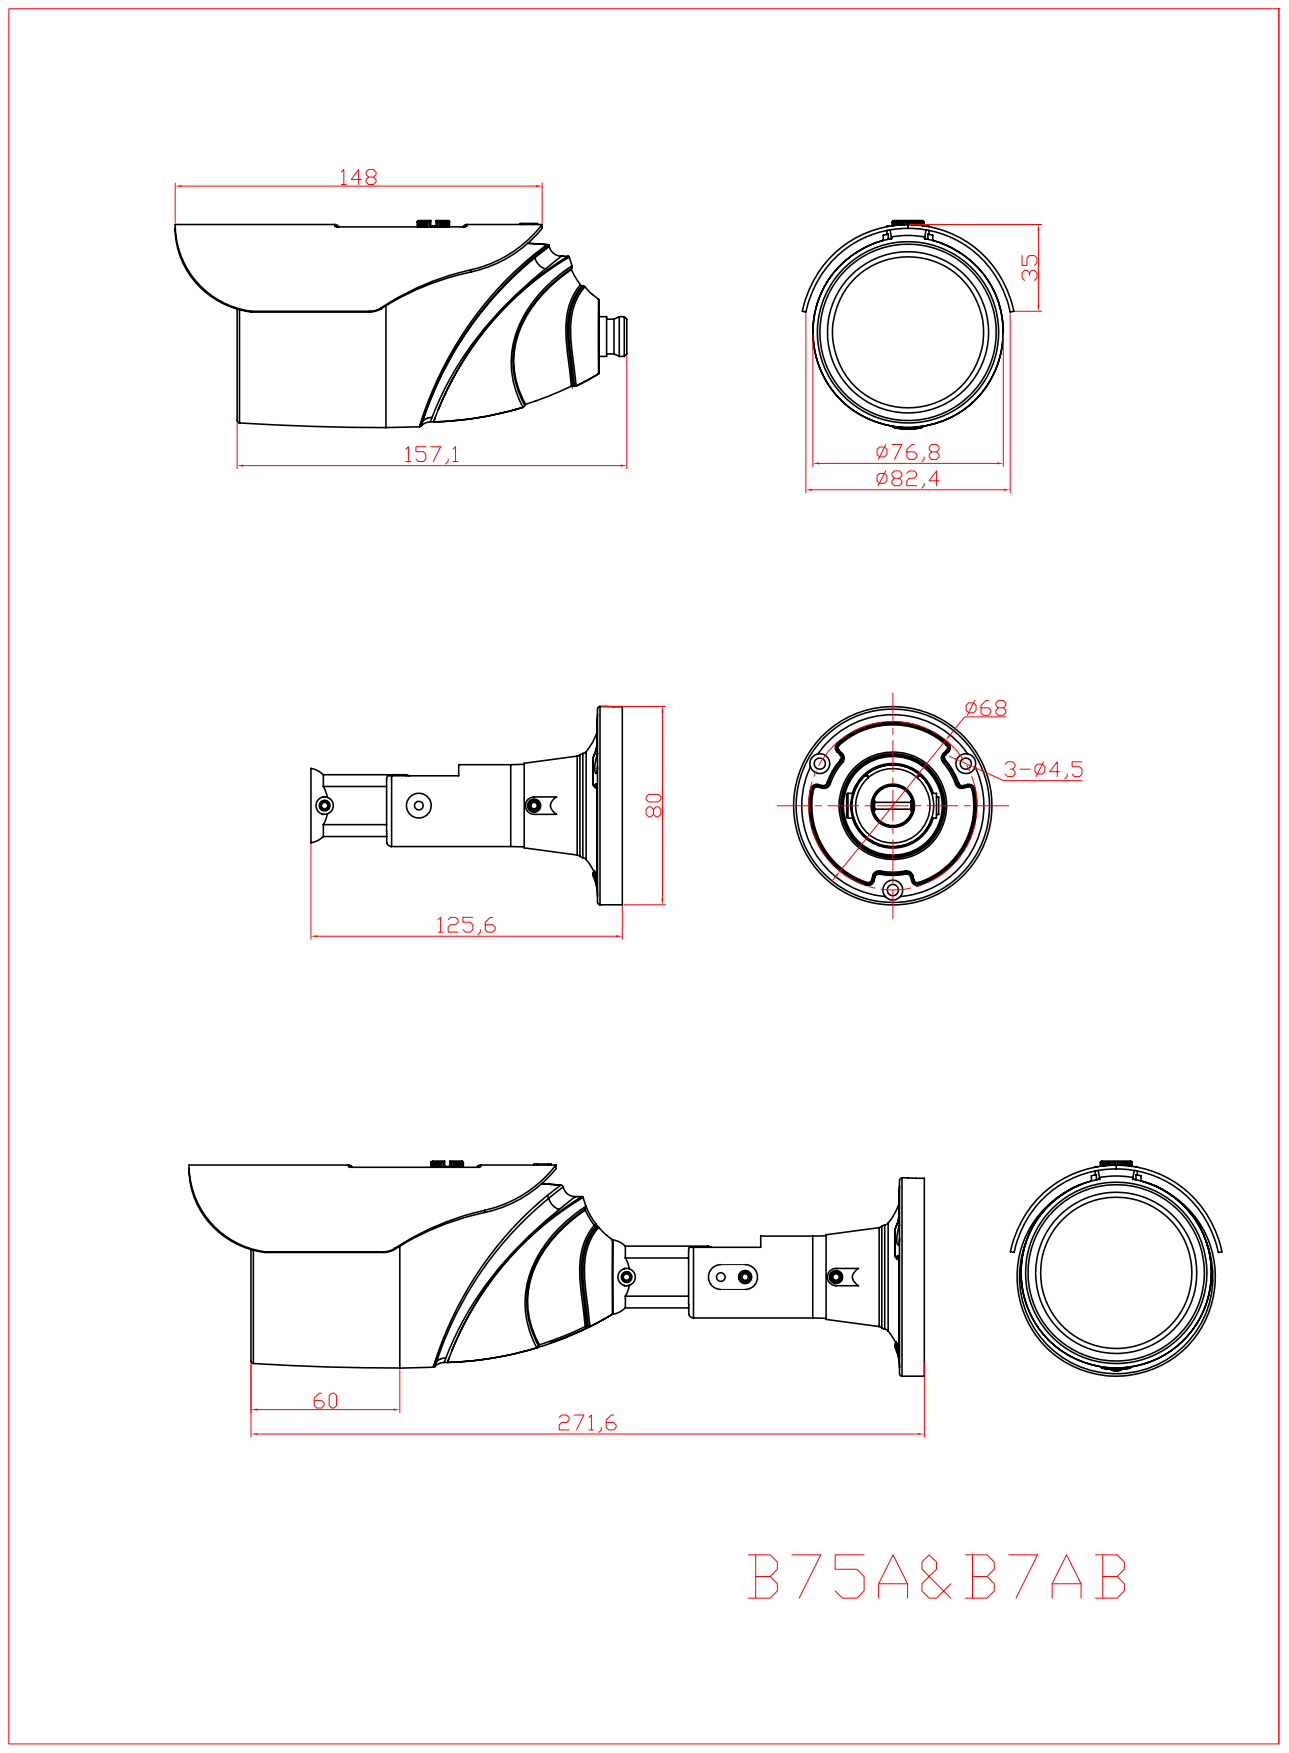
[picture p20: page 1]
