hanskimvz/NS6202HD/(list of files, drawings)

Other design files:
schematic/NS6202_V1.0.DSN
schematic/ns6202_v1.0.opj
schematic/NS6202_V1.0.PcbDoc
schematic/NS6202_V1.0.PrjPcb
schematic/NS6202_V2.0.DSN
schematic/ns6202_v2.0.opj
schematic/NS6202_V2.0.PcbDoc
schematic/NS6202_V2.0.PrjPcb
schematic/NS6202_V3.0.DSN
schematic/ns6202_v3.0.opj
schematic/NS6202_V3.0.PcbDoc
schematic/NS6202_V3.0.PrjPcb
schematic/NS6202_V4.0.DSN
schematic/NS6202_V4.0.opj
schematic/NS6202_V4.0.PcbDoc
schematic/NS6202_V4.0.PrjPcb
schematic/NS6202_V4.0_b.PcbDoc
schematic/NS6202_V4.0_SD.DSN
schematic/ns6202_v4.0_sd.opj
schematic/NS6202_V4.0_SDCARD.PcbDoc
schematic/NS6202_V4.1.DSN
schematic/ns6202_v4.1.opj
schematic/NS6202_V4.1.PcbDoc
schematic/NS6202_V4.1.PrjPcb
